Jannakis/Heated-Bushing/docs/images/bushing_holder.jpg

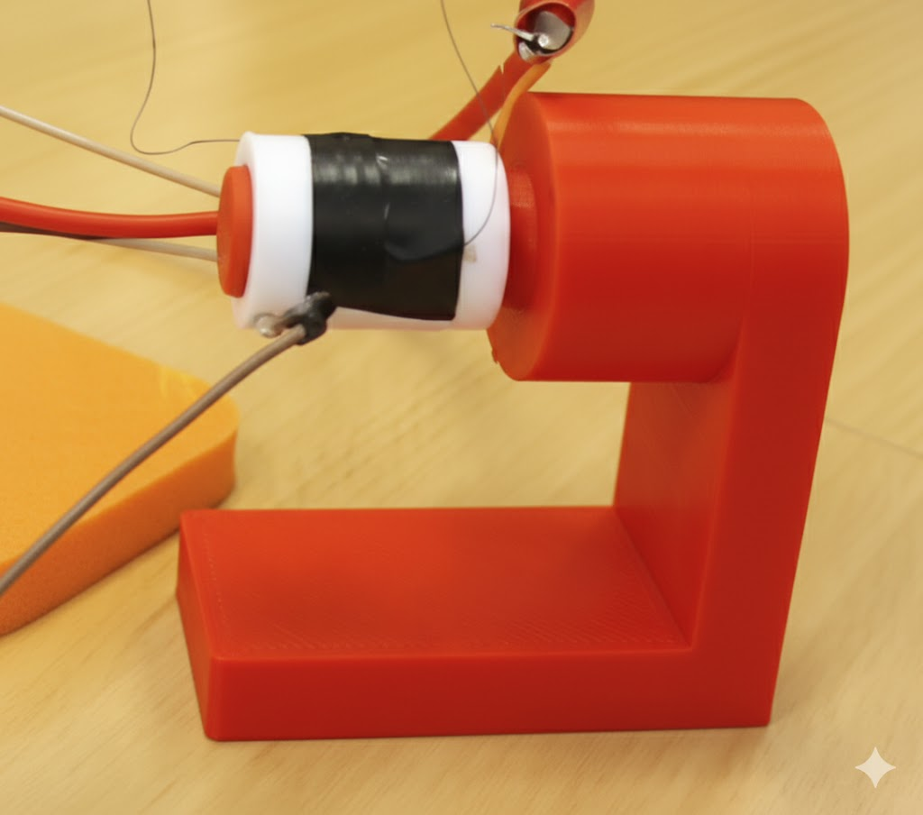
docs/images/bushing_holder.jpg
