Jannakis/Heated-Bushing/docs/images/iteration4_side_outlet.png

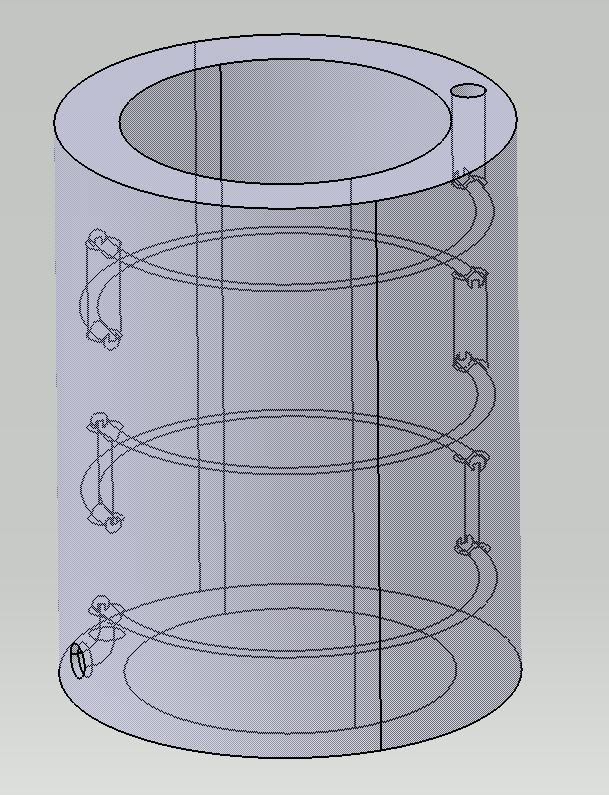
docs/images/iteration4_side_outlet.png
