Jannakis/Heated-Bushing/docs/images/testplate_design.png

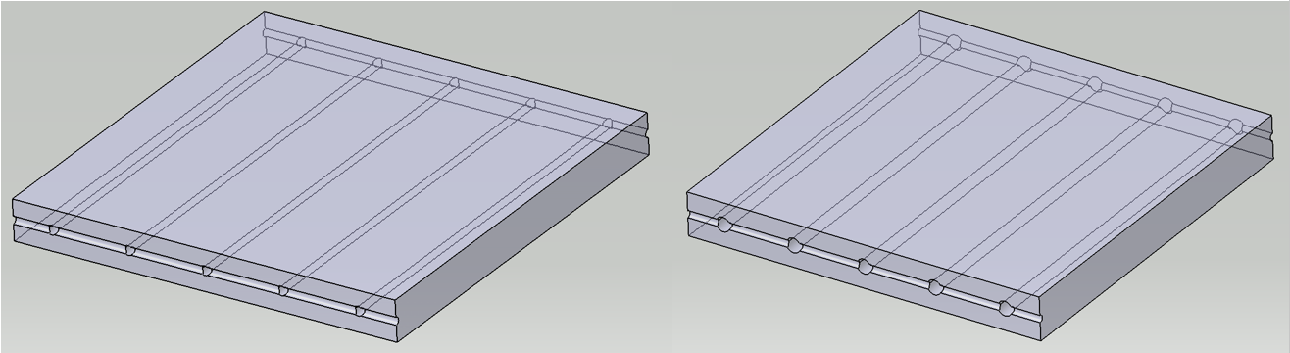
docs/images/testplate_design.png
