Jannakis/Heated-Bushing/docs/images/thermal_measurement.png

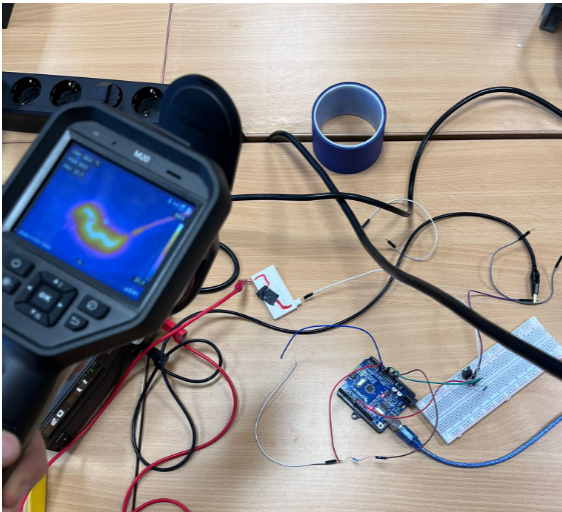
docs/images/thermal_measurement.png
