Jannakis/Heated-Bushing/(commit log)

2026-03-01 Enhance README with wiring diagrams and images
    Added wiring diagrams and images to the README.
2026-03-01 Revise README for clarity and structure
    Updated the README to provide a clearer overview of the closed-loop temperature control system, including hardware details, highlights, repository structure, and documentation references.
